willbrubio/fed-scale/old/STlFiles/windowCover(4-19).stl

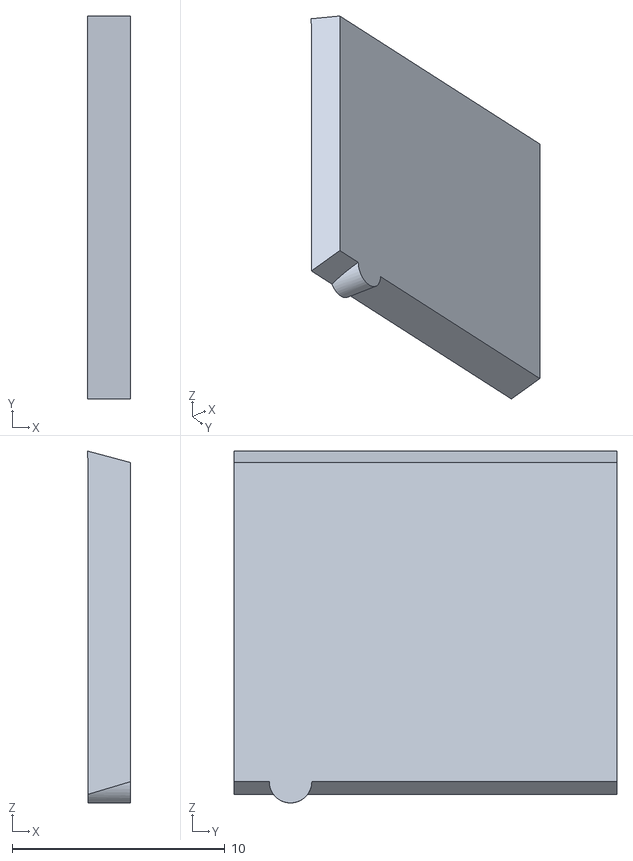
[picture p1: CAD file, 2026-08-31, an earlier design]
old/STlFiles/windowCover(4-19).stl
2.01 x 18.0 x 16.5
