willbrubio/fed-scale/old/STlFiles/tubeWithGrasps(4-19).stl

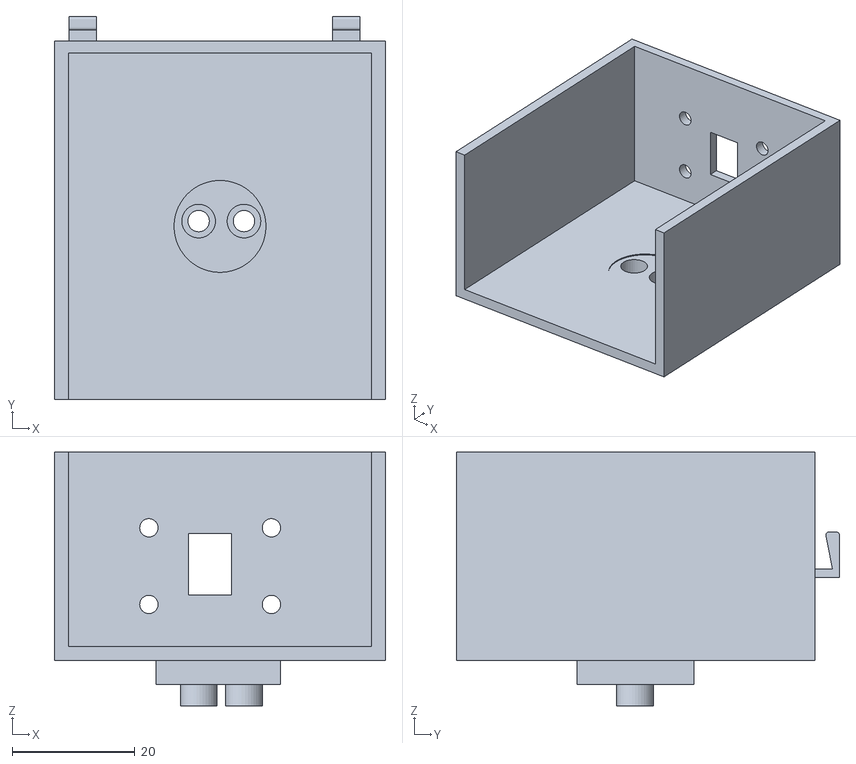
[picture p2: CAD file, 2026-08-31, an earlier design]
old/STlFiles/tubeWithGrasps(4-19).stl
54.0 x 62.5 x 41.4
