willbrubio/fed-scale/old/STlFiles/bottomWalls(4-19)(flash_window_only).stl

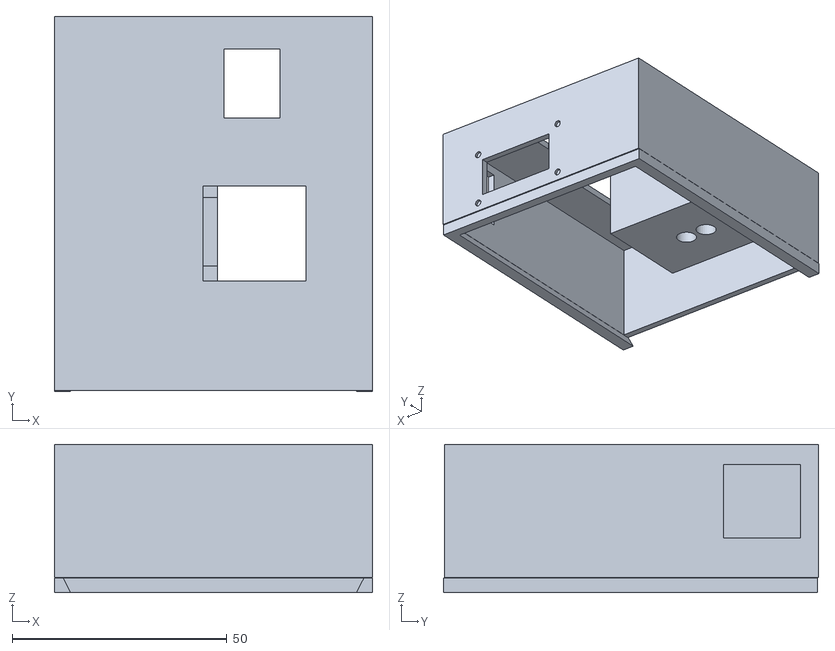
[picture p3: CAD file, 2026-08-31, an earlier design]
old/STlFiles/bottomWalls(4-19)(flash_window_only).stl
74.0 x 87.3 x 34.5
