willbrubio/fed-scale/old/STlFiles/bottomLid4(4-19).stl

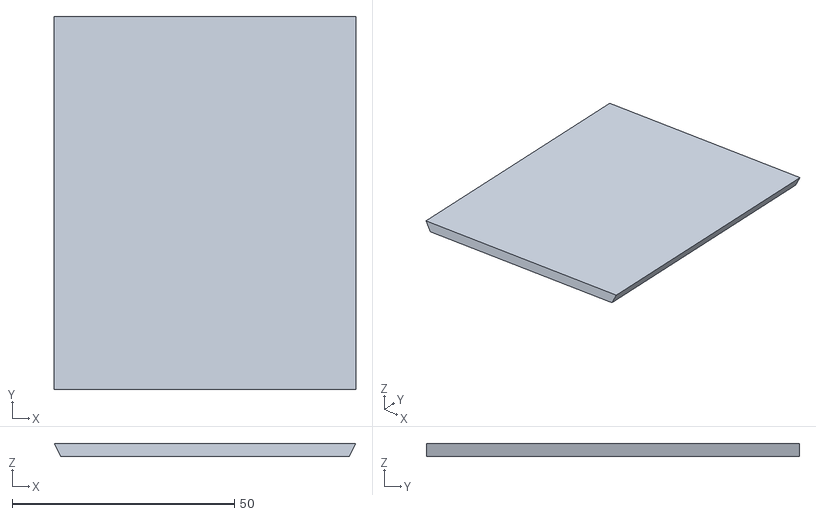
[picture p4: CAD file, 2026-08-31, an earlier design]
old/STlFiles/bottomLid4(4-19).stl
68.0 x 84.0 x 3.00
