willbrubio/fed-scale/old/STlFiles/proxCover(4-19).stl

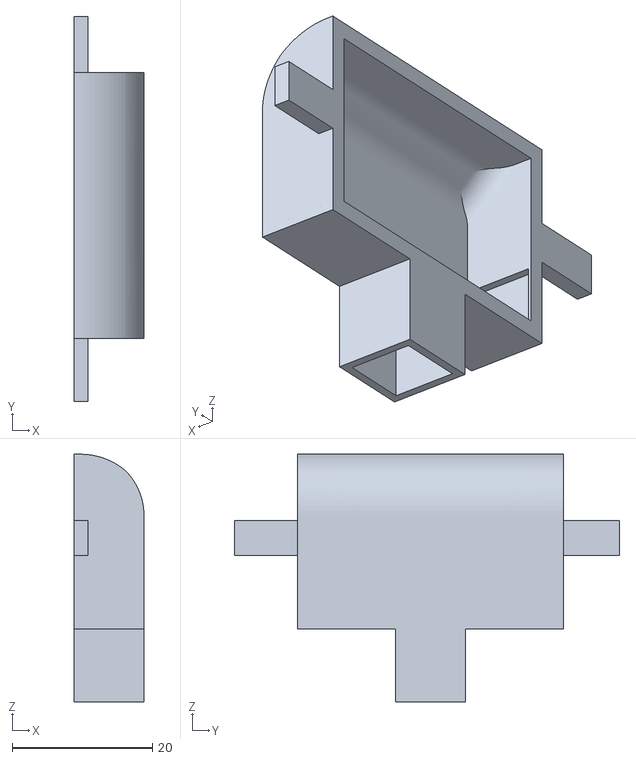
[picture p5: CAD file, 2026-08-31, an earlier design]
old/STlFiles/proxCover(4-19).stl
10.0 x 55.0 x 35.4
