willbrubio/fed-scale/old/STlFiles/windowSlider(4-19).stl

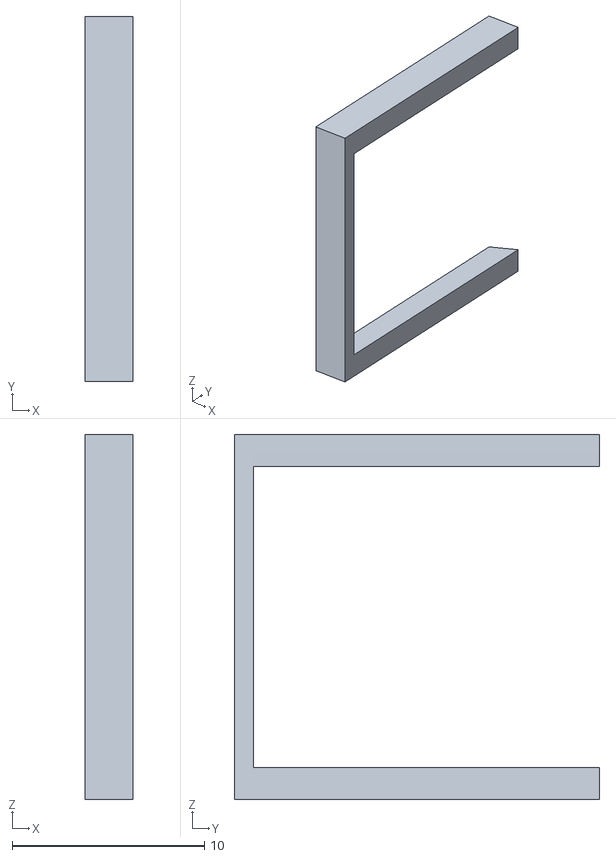
[picture p6: CAD file, 2026-08-31, an earlier design]
old/STlFiles/windowSlider(4-19).stl
2.50 x 19.0 x 19.0
