willbrubio/fed-scale/pilot_run_20261109/Manual Weights.xlsx

Date | Time | Weight (g)
2026-11-09 | 2:12:00 | 31.5
2026-11-09 | 6:26:00 | 31.64
2026-11-10 | 10:40:00 | 32.18
2026-11-10 | 6:03:00 | 31.63
