willbrubio/fed-scale/TESTDATA/THRM0013.CSV

iso | unixtime | millis | px0 | px1 | px2 | px3 | px4 | px5 | px6 | px7 | px8 | px9 | px10 | px11 | px12 | px13 | px14 | px15 | px16 | px17 | px18 | px19 | px20 | px21 | px22 | px23 | px24 | px25 | px26 | px27 | px28 | px29 | px30 | px31 | px32 | px33 | px34 | px35 | px36 | px37 | px38 | px39 | px40 | px41 | px42 | px43 | px44 | px45 | px46 | px47 | px48 | px49 | px50 | px51 | px52 | px53 | px54 | px55 | px56
2026-08-28 09:04:56 | 1787907896 | 1918 | 23.8 | 25.0 | 25.3 | 24.8 | 24.0 | 23.3 | 23.5 | 24.5 | 24.8 | 24.0 | 23.5 | 25.0 | 25.3 | 25.5 | 24.3 | 24.5 | 23.8 | 24.5 | 24.3 | 24.0 | 24.5 | 24.8 | 25.8 | 23.8 | 23.3 | 23.8 | 24.3 | 23.8 | 24.3 | 24.8 | 26.0 | 25.0 | 23.5 | 23.3 | 24.0 | 24.5 | 24.8 | 25.3 | 26.3 | 27.5 | 23.3 | 23.8 | 23.5 | 24.0 | 24.5 | 25.5 | 27.0 | 27.3 | 22.5 | 23.3 | 23.0 | 23.5 | 24.0 | 25.0 | 26.5 | 27.5 | 22.5
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
