willbrubio/fed-scale/TESTDATA/figures/Figure_1.png

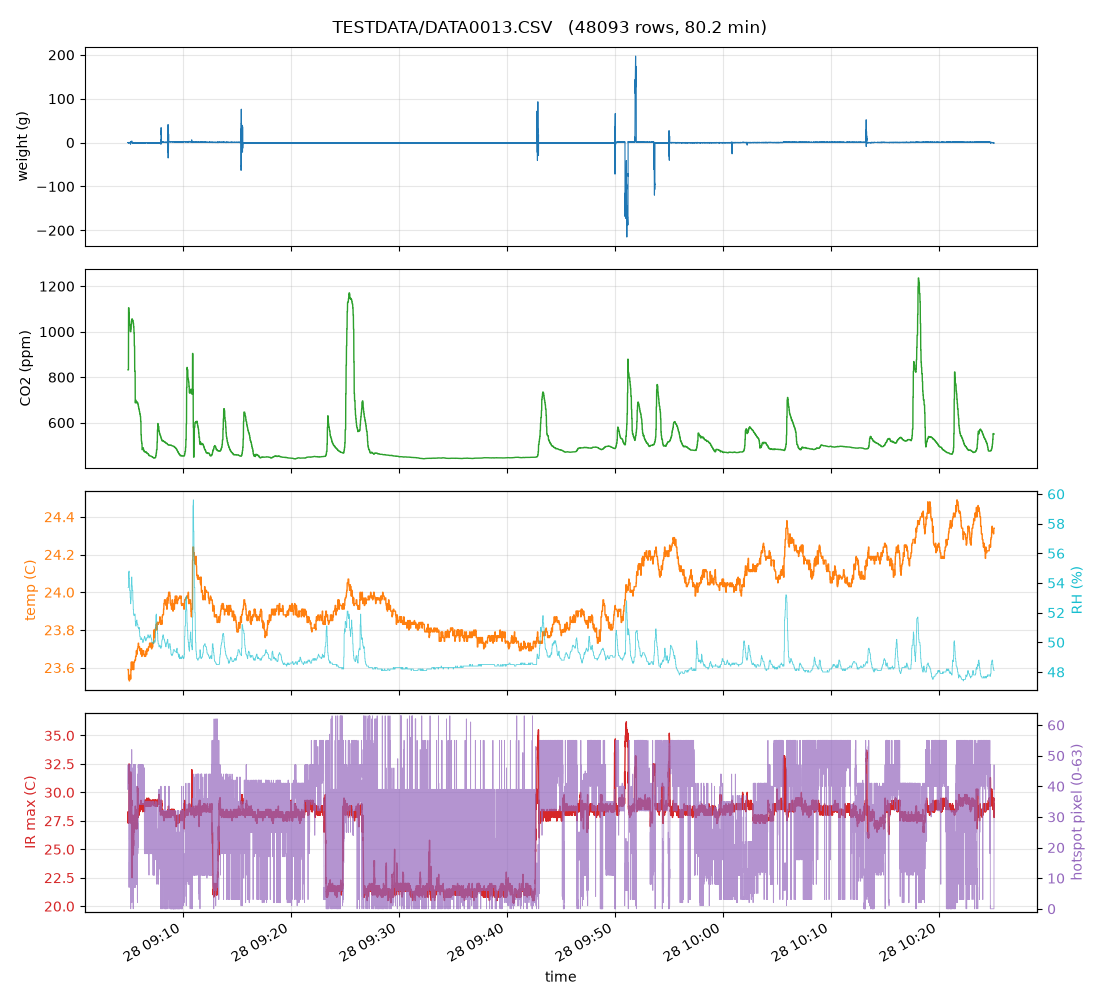
TESTDATA/figures/Figure_1.png
