willbrubio/fed-scale/TESTDATA/figures/Figure_2.png

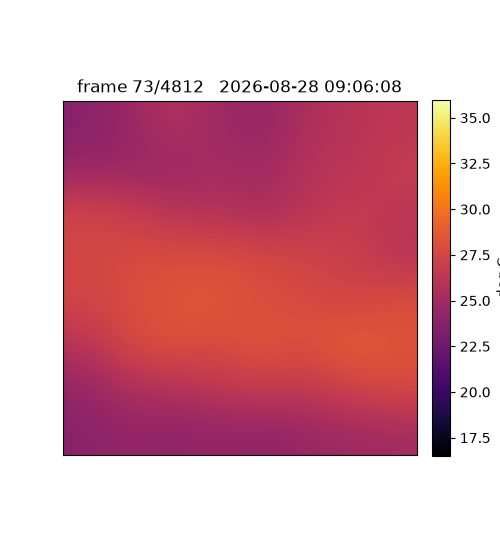
TESTDATA/figures/Figure_2.png
