willbrubio/fed-scale/(commit log)

2026-08-24 added mouse scale logger arduino code that attempts to bring in RTC
2026-08-31 Reorganized the project
    [DATA0013.CSV, ScaleBreakoutBoard2.0.brd, ScaleBreakoutBoard2.0.sch, THRM0013.CSV, bottomLid4(4-19).stl, bottomWalls(4-19)(flash_window_only).stl, proxCover(4-19).stl, tubeWithGrasps(4-19).stl]
2026-09-30 add new Arduino test code for mouse scale logger environment 2
